esar/sieg-sc4-els/README.md

# sieg-sc4-els
SIEG SC4 Electronic Lead Screw

This is an electronic lead screw controller designed for the SIEG SC4 lathe, though it would also work fine for others.

This repo contains the Kicad files for the controller PCB and the firmware.

See https://hacks.esar.org.uk/sieg-sc4-electronic-lead-screw/ for more details
