esar/sieg-sc4-els/board/sieg-sc4-els.kicad_pcb

## KiCad design board/sieg-sc4-els.kicad_pcb (2023-07-16)

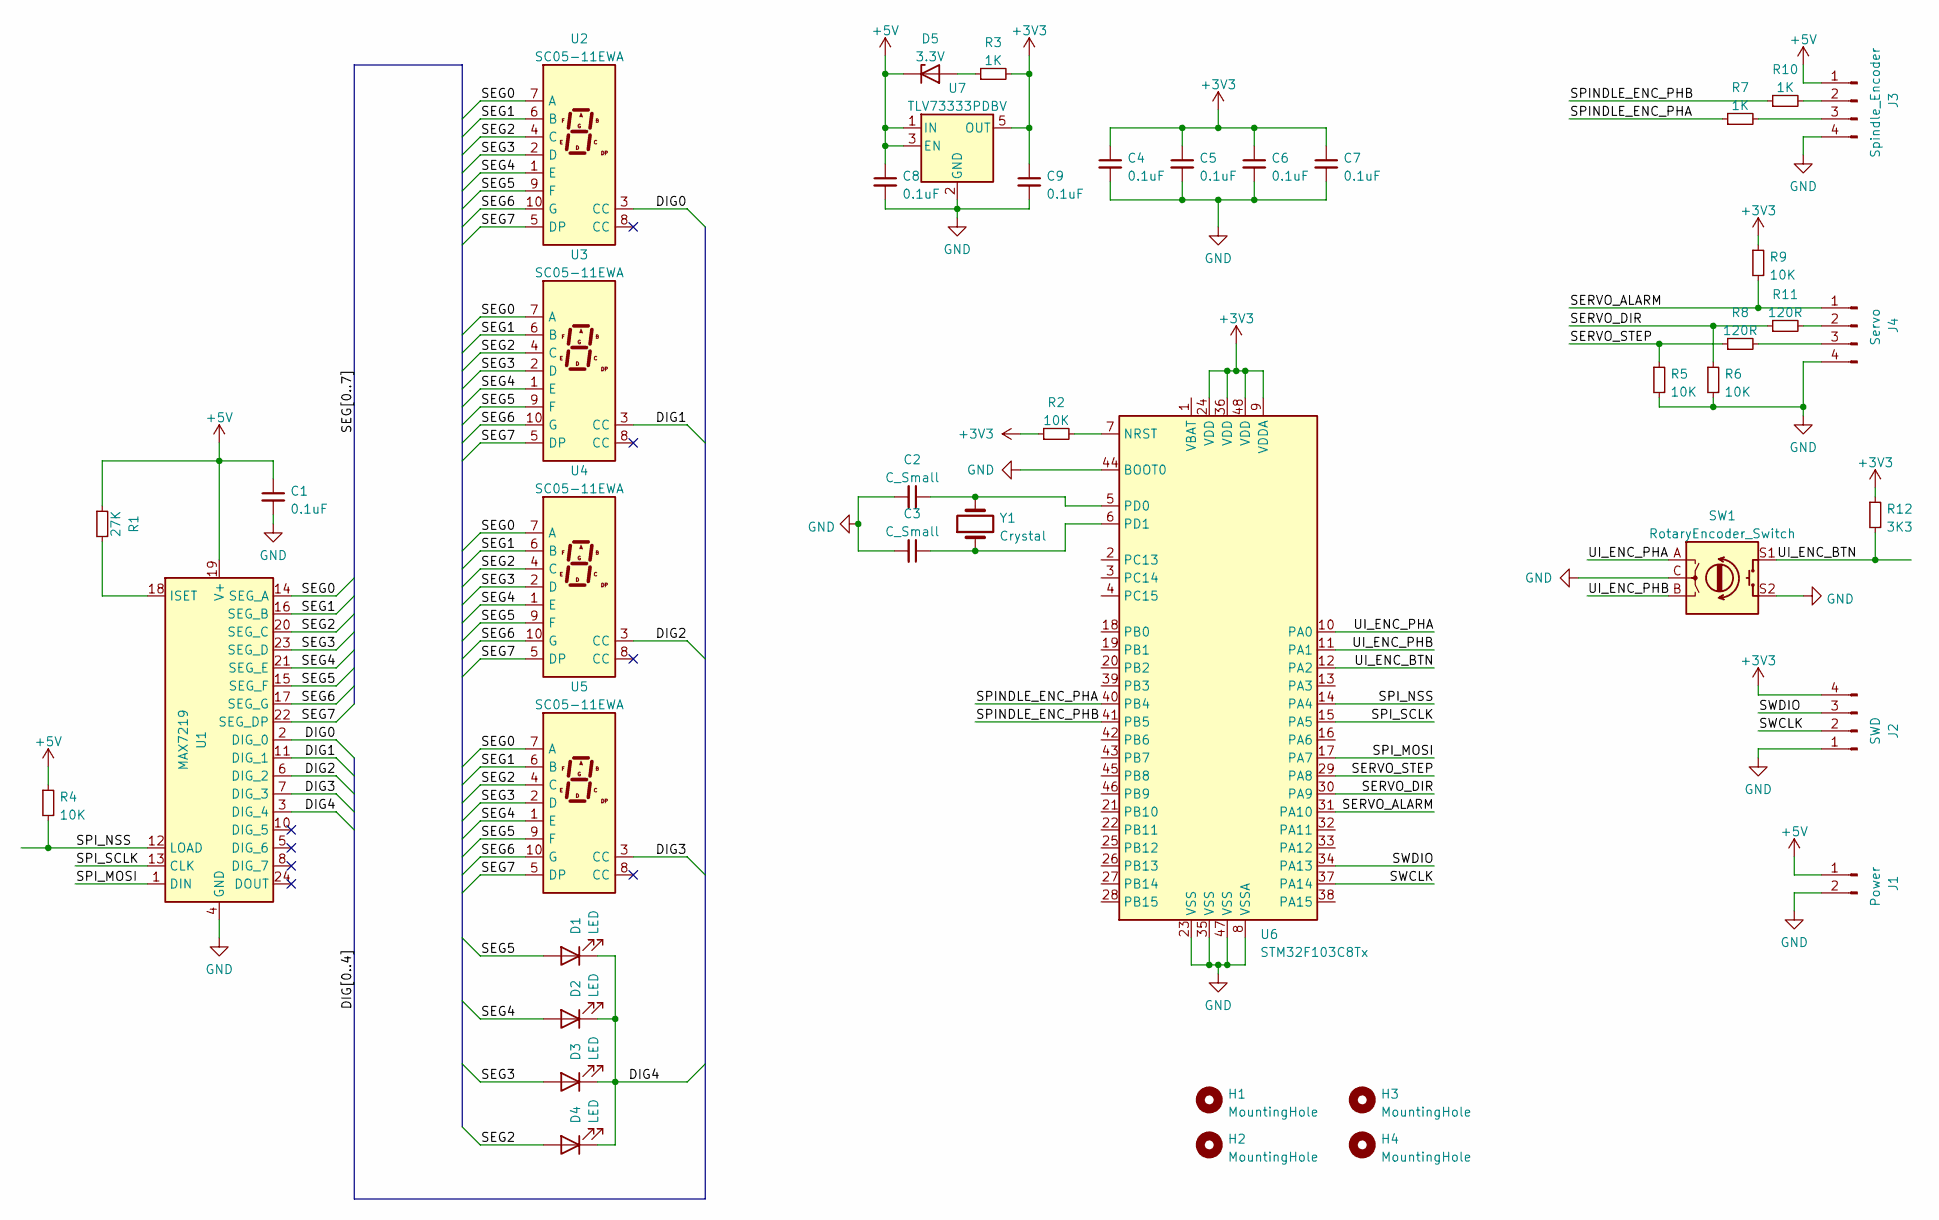
[picture p1: schematic sieg-sc4-els.kicad_sch]

Parts:
C1, C4, C5, C6, C7, C8, C9: 0.1uF; C_0603_1608Metric
C2, C3: C_Small; C_0603_1608Metric
D1, D2, D3, D4: LED; LED_D3.0mm
D5: 3.3V; D_SOD-323
H1, H2, H3, H4: MountingHole; MountingHole_3.2mm_M3
J1: Power; JST_XH_B2B-XH-A_1x02_P2.50mm_Vertical
J2: SWD; JST_XH_B4B-XH-A_1x04_P2.50mm_Vertical
J3: Spindle_Encoder; JST_XH_B4B-XH-A_1x04_P2.50mm_Vertical
J4: Servo; JST_XH_B4B-XH-A_1x04_P2.50mm_Vertical
R1: 27K; R_0603_1608Metric
R2, R4, R5, R6, R9: 10K; R_0603_1608Metric
R3, R7, R10: 1K; R_0603_1608Metric
R8, R11: 120R; R_0603_1608Metric
R12: 3K3; R_0603_1608Metric
SW1: RotaryEncoder_Switch; RotaryEncoder_Alps_EC11E-Switch_Vertical_H20mm
U1: MAX7219; SOIC-24W_7.5x15.4mm_P1.27mm
U2, U3, U4, U5: SC05-11EWA; D1X8K
U6: STM32F103C8Tx; LQFP-48_7x7mm_P0.5mm
U7: TLV73333PDBV; SOT-23-5
Y1: Crystal; Crystal_SMD_SeikoEpson_MA505-2Pin_12.7x5.1mm

Connections:
+3V3: C4.1, C5.1, C6.1, C7.1, C9.1, J2.4, R2.1, R3.2, R9.1, R12.1, U6.9 (VDDA), U6.24 (VDD), U6.36 (VDD), U6.48 (VDD), U7.5 (OUT)
+5V: C1.1, C8.1, D5.1 (K), J1.1, J3.1, R1.1, R4.1, U1.19 (V+), U7.1 (IN), U7.3 (EN)
/DIG0: U1.2 (DIG_0), U2.3 (CC)
/DIG1: U1.11 (DIG_1), U3.3 (CC)
/DIG2: U1.6 (DIG_2), U4.3 (CC)
/DIG3: U1.7 (DIG_3), U5.3 (CC)
/DIG4: D1.1 (K), D2.1 (K), D3.1 (K), D4.1 (K), U1.3 (DIG_4)
/SEG0: U1.14 (SEG_A), U2.7 (A), U3.7 (A), U4.7 (A), U5.7 (A)
/SEG1: U1.16 (SEG_B), U2.6 (B), U3.6 (B), U4.6 (B), U5.6 (B)
/SEG2: D4.2 (A), U1.20 (SEG_C), U2.4 (C), U3.4 (C), U4.4 (C), U5.4 (C)
/SEG3: D3.2 (A), U1.23 (SEG_D), U2.2 (D), U3.2 (D), U4.2 (D), U5.2 (D)
/SEG4: D2.2 (A), U1.21 (SEG_E), U2.1 (E), U3.1 (E), U4.1 (E), U5.1 (E)
/SEG5: D1.2 (A), U1.15 (SEG_F), U2.9 (F), U3.9 (F), U4.9 (F), U5.9 (F)
/SEG6: U1.17 (SEG_G), U2.10 (G), U3.10 (G), U4.10 (G), U5.10 (G)
/SEG7: U1.22 (SEG_DP), U2.5 (DP), U3.5 (DP), U4.5 (DP), U5.5 (DP)
/SERVO_ALARM: J4.1, R9.2, U6.31 (PA10)
/SERVO_DIR: R6.1, R11.1, U6.30 (PA9)
/SERVO_STEP: R5.1, R8.1, U6.29 (PA8)
/SPINDLE_ENC_PHA: R7.1, U6.40 (PB4)
/SPINDLE_ENC_PHB: R10.1, U6.41 (PB5)
/SPI_MOSI: U1.1 (DIN), U6.17 (PA7)
/SPI_NSS: R4.2, U1.12 (LOAD), U6.14 (PA4)
/SPI_SCLK: U1.13 (CLK), U6.15 (PA5)
/SWCLK: J2.2, U6.37 (PA14)
/SWDIO: J2.3, U6.34 (PA13)
/UI_ENC_BTN: R12.2, SW1.S1, U6.12 (PA2)
/UI_ENC_PHA: SW1.A, U6.10 (PA0)
/UI_ENC_PHB: SW1.B, U6.11 (PA1)
GND: C1.2, C2.2, C3.2, C4.2, C5.2, C6.2, C7.2, C8.2, C9.2, J1.2, J2.1, J3.4, J4.4, R5.2, R6.2, SW1.C, SW1.S2, U1.4 (GND), U1.9 (GND), U6.8 (VSSA), U6.23 (VSS), U6.35 (VSS), U6.44 (BOOT0), U6.47 (VSS), U7.2 (GND)
unnamed: C2.1, U6.5 (PD0), Y1.2
unnamed: C3.1, U6.6 (PD1), Y1.1
unnamed: D5.2 (A), R3.1
unnamed: J3.2, R10.2
unnamed: J3.3, R7.2
unnamed: J4.2, R11.2
unnamed: J4.3, R8.2
unnamed: R1.2, U1.18 (ISET)
unnamed: R2.2, U6.7 (NRST)

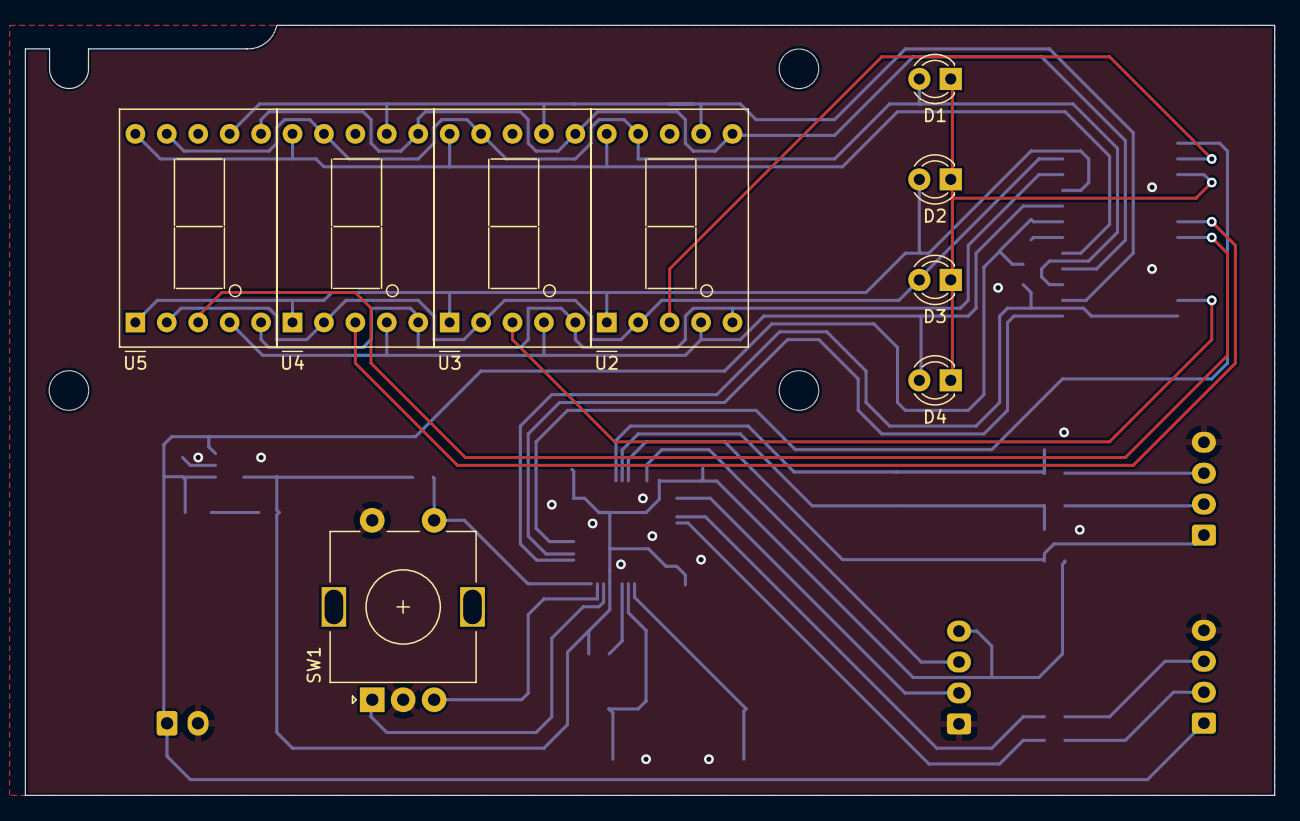
[picture p2: board sieg-sc4-els.kicad_pcb from above]

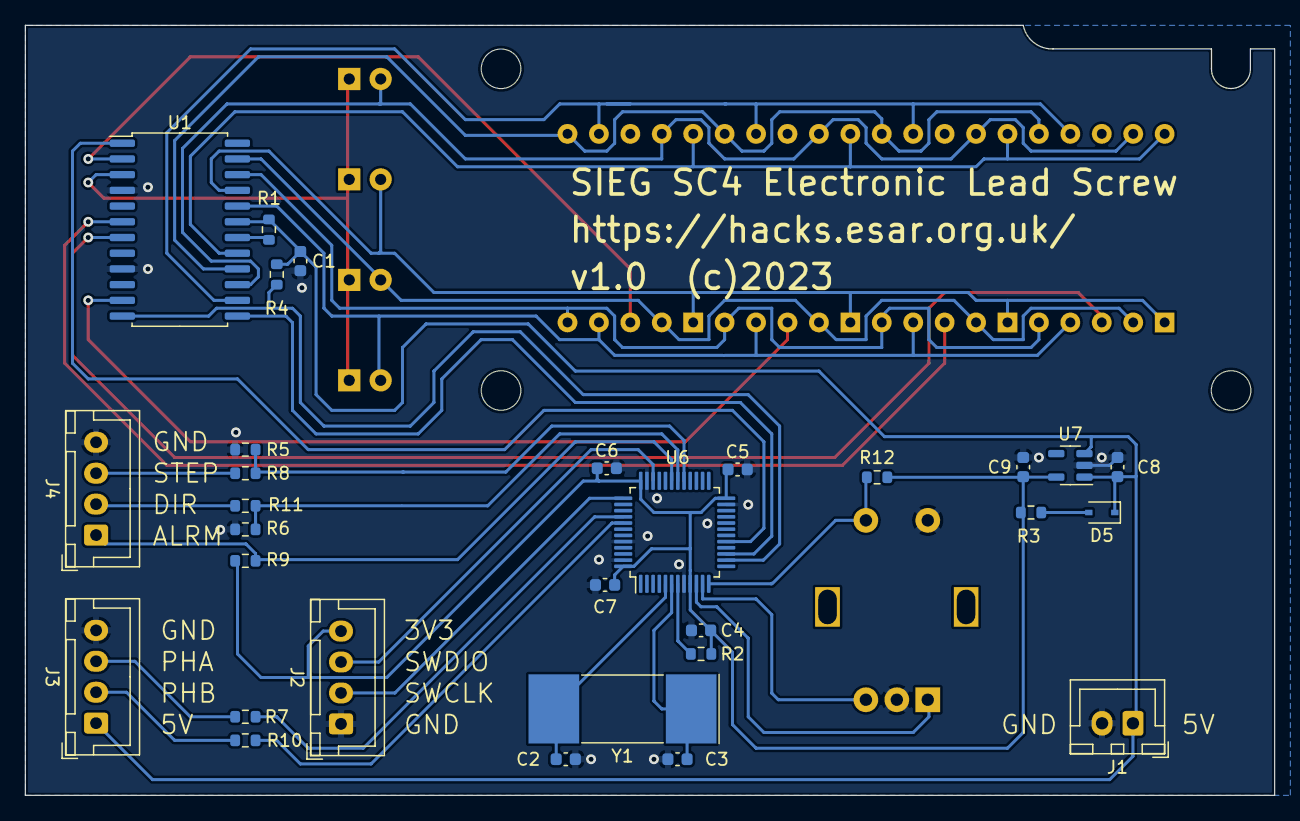
[picture p3: board sieg-sc4-els.kicad_pcb from below]

Board: 2 copper layers, 101.0 x 62.2 mm, 42 parts (30 on the bottom side), 38 nets.
