esar/sieg-sc4-els/(notices)

Notices in the files:
input.c:
Sieg SC4 ELS is free software: you can redistribute it and/or modify
it under the terms of the GNU General Public License as published by
the Free Software Foundation, either version 2 of the License, or
(at your option) any later version.
board/sieg-sc4-els.kicad_pcb:
v1.0 (c)2023
